sneelocke/Arduino-Uno-Midi-Xylophone/schematic before IO expanded.jpg

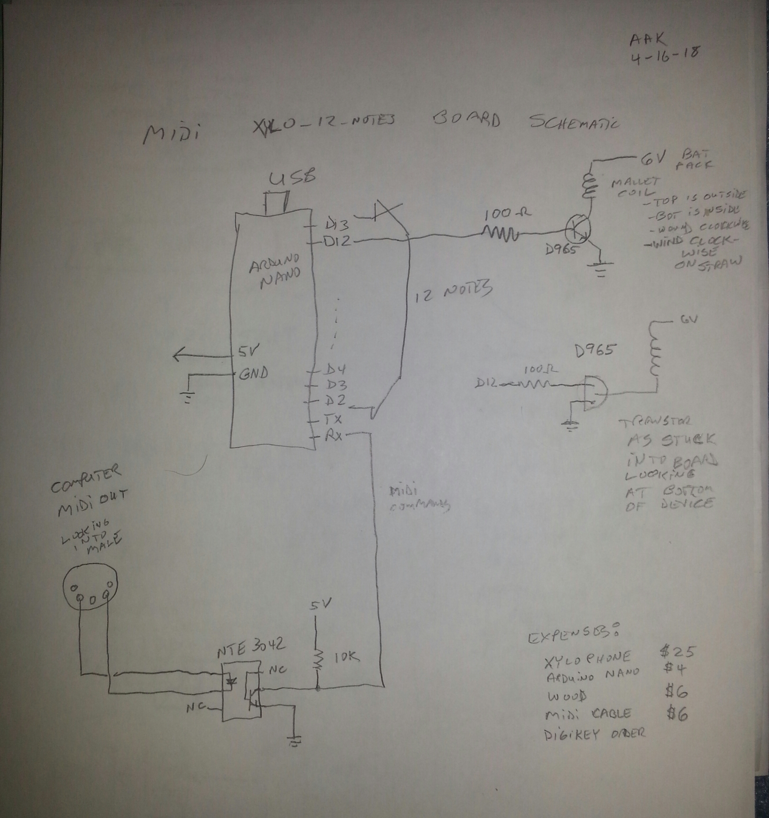
schematic before IO expanded.jpg
