sneelocke/Arduino-Uno-Midi-Xylophone/schematic overview.jpg

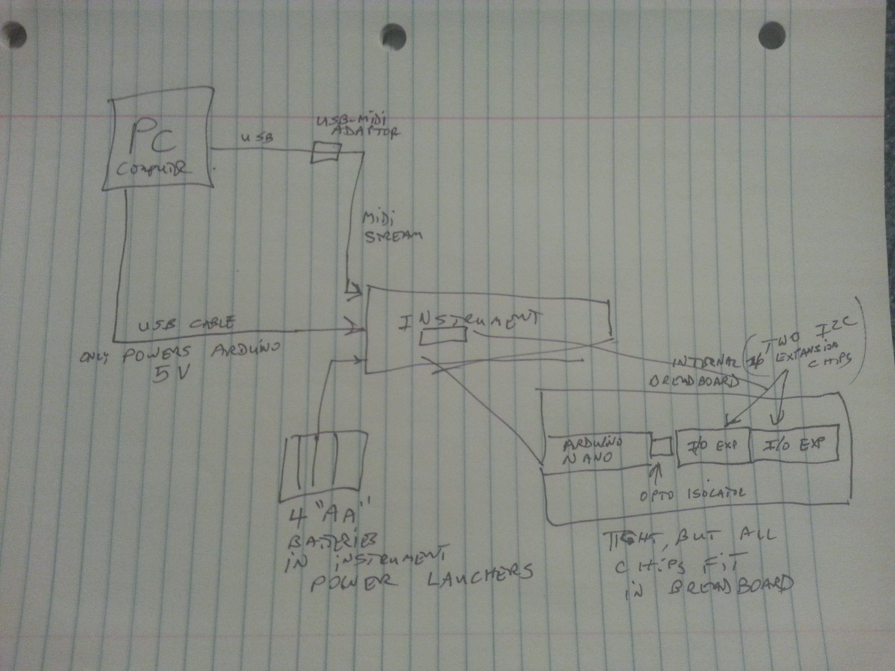
schematic overview.jpg
