sneelocke/Arduino-Uno-Midi-Xylophone/instrument layout.jpg

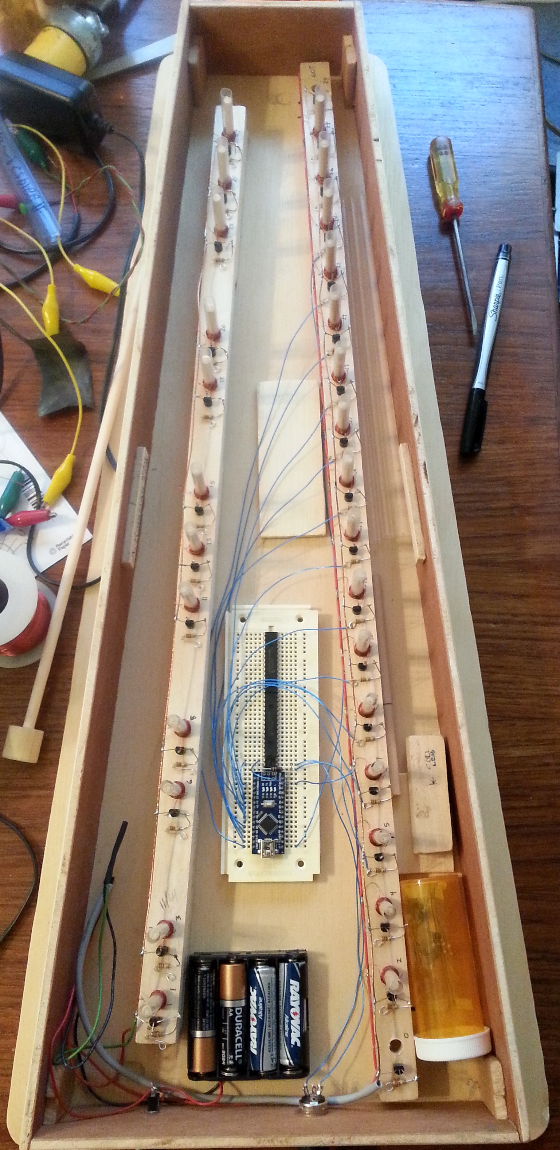
instrument layout.jpg
