sneelocke/Arduino-Uno-Midi-Xylophone/launch rail transistors.jpg

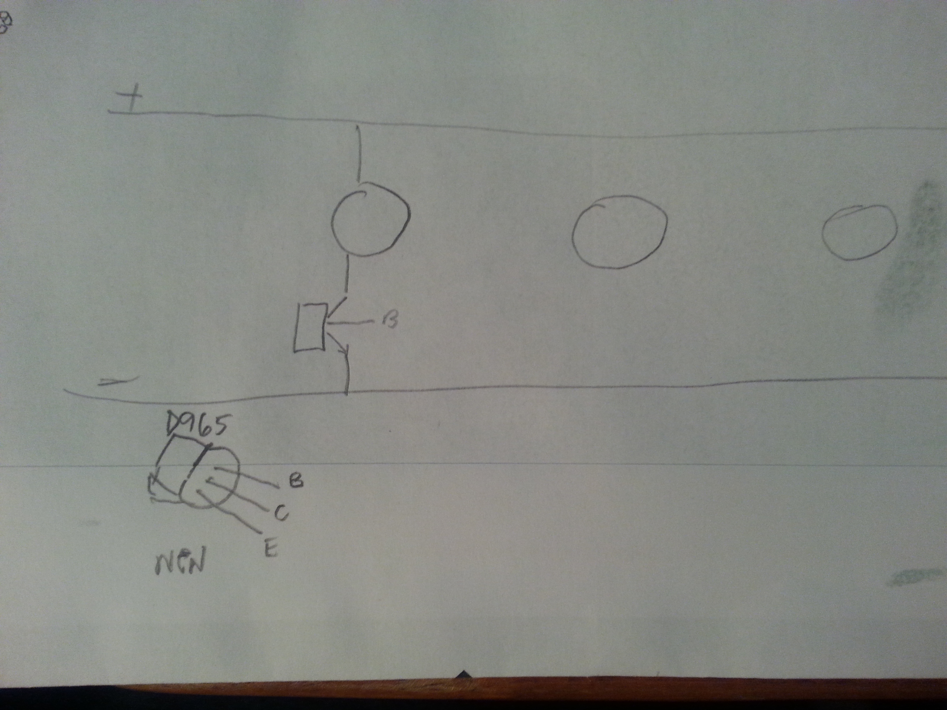
launch rail transistors.jpg
