sneelocke/Arduino-Uno-Midi-Xylophone/MIDI connection schematics.png

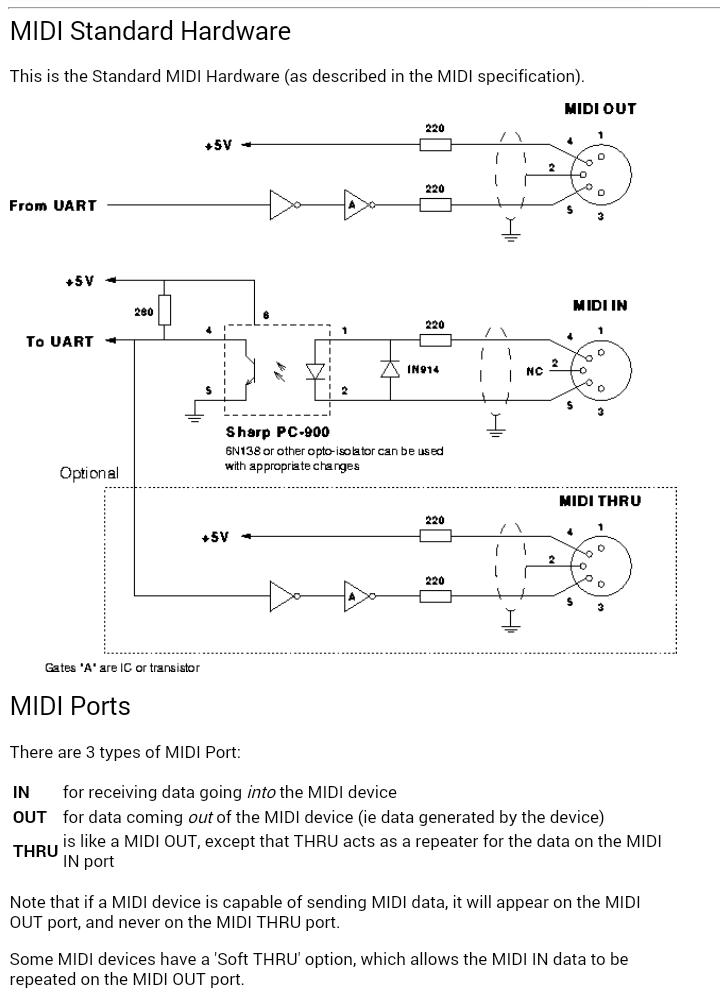
MIDI connection schematics.png
