sneelocke/Arduino-Uno-Midi-Xylophone/NTE3042.jpg

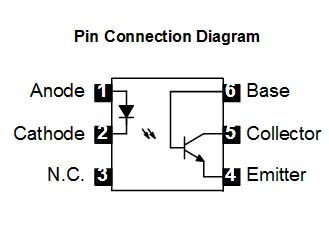
NTE3042.jpg
