sneelocke/Arduino-Uno-Midi-Xylophone/rail closeup.jpg

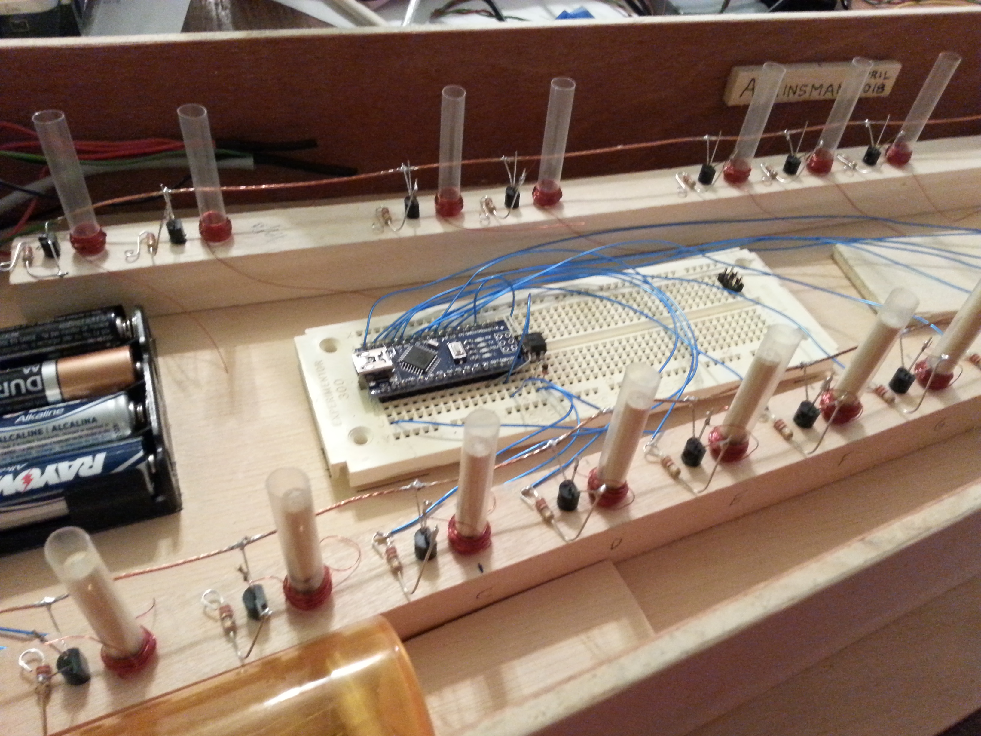
rail closeup.jpg
