sneelocke/Arduino-Uno-Midi-Xylophone/schematic1.jpg

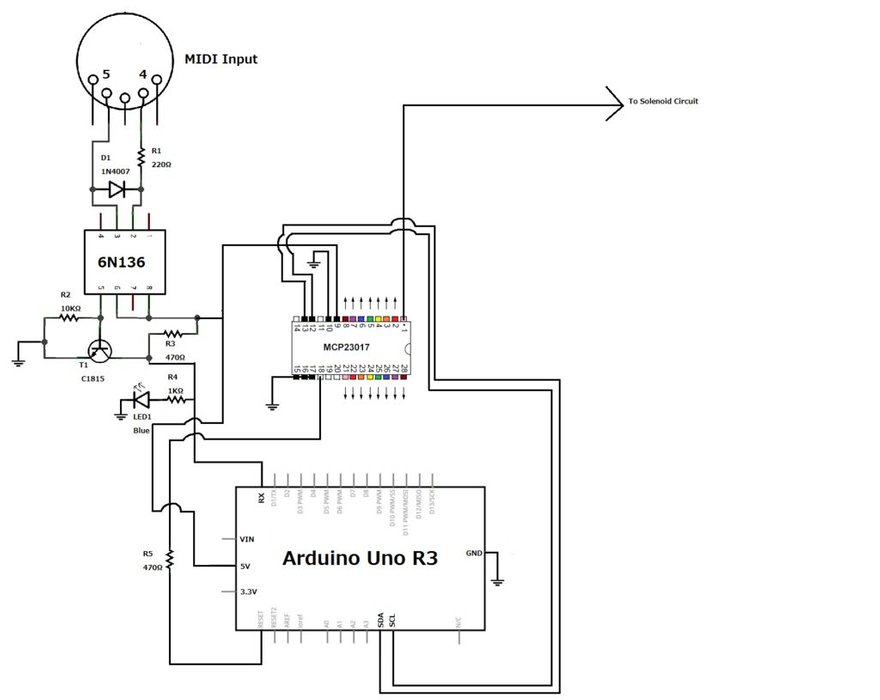
schematic1.jpg
