sneelocke/Arduino-Uno-Midi-Xylophone/schematic2.jpg

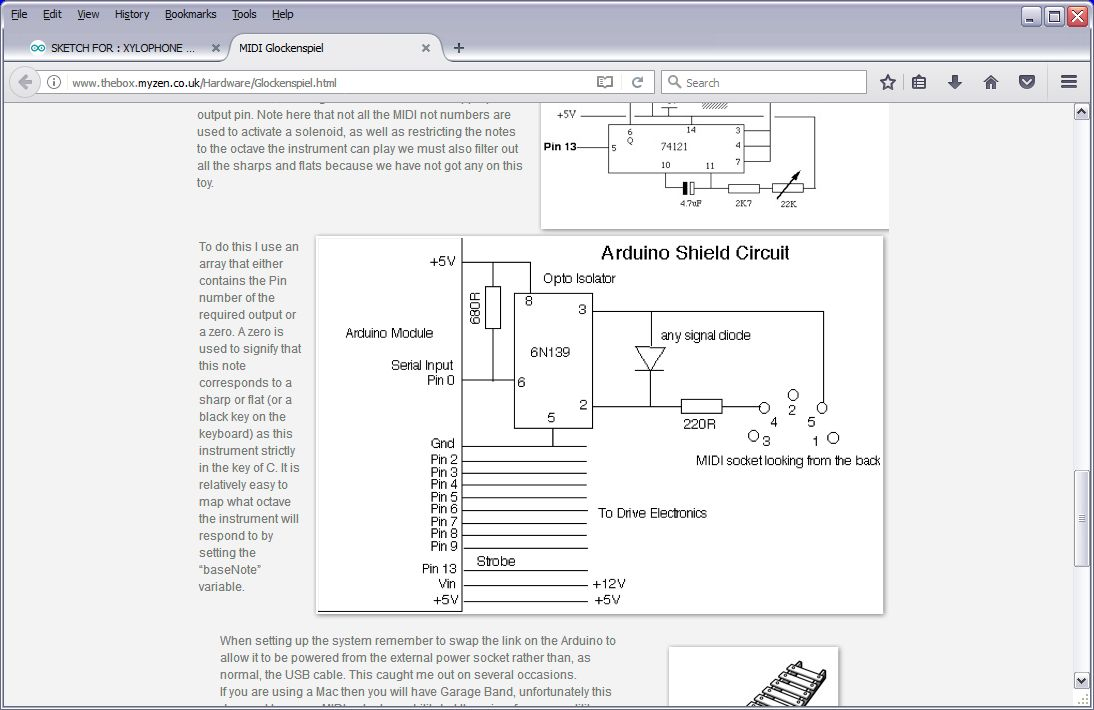
schematic2.jpg
