sneelocke/Arduino-Uno-Midi-Xylophone/USB MIDI adaptor.jpg

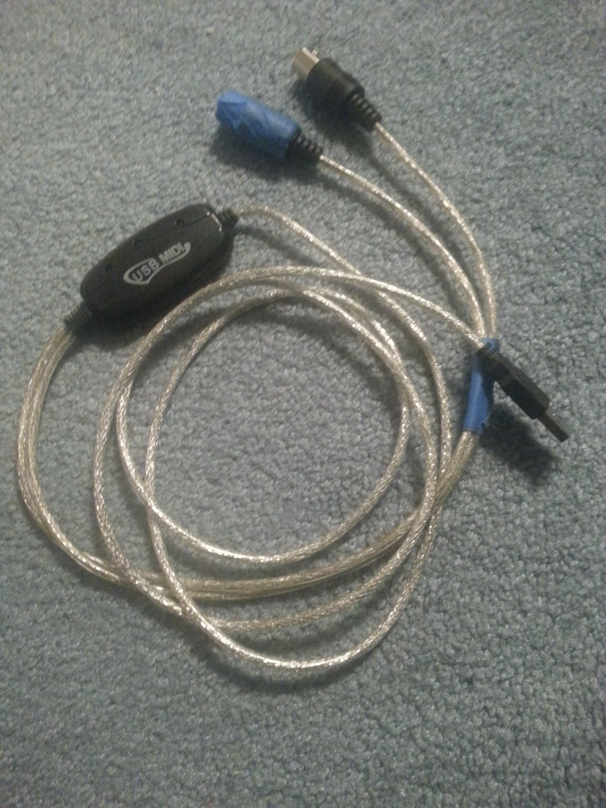
USB MIDI adaptor.jpg
